bjoerke/DMM-counter-multimeter/README.md

# DMM-counter-multimeter
Impulszähler und Multimeter für das DMM-Board
