bjoerke/DMM-counter-multimeter/hardware/schematic.pdf

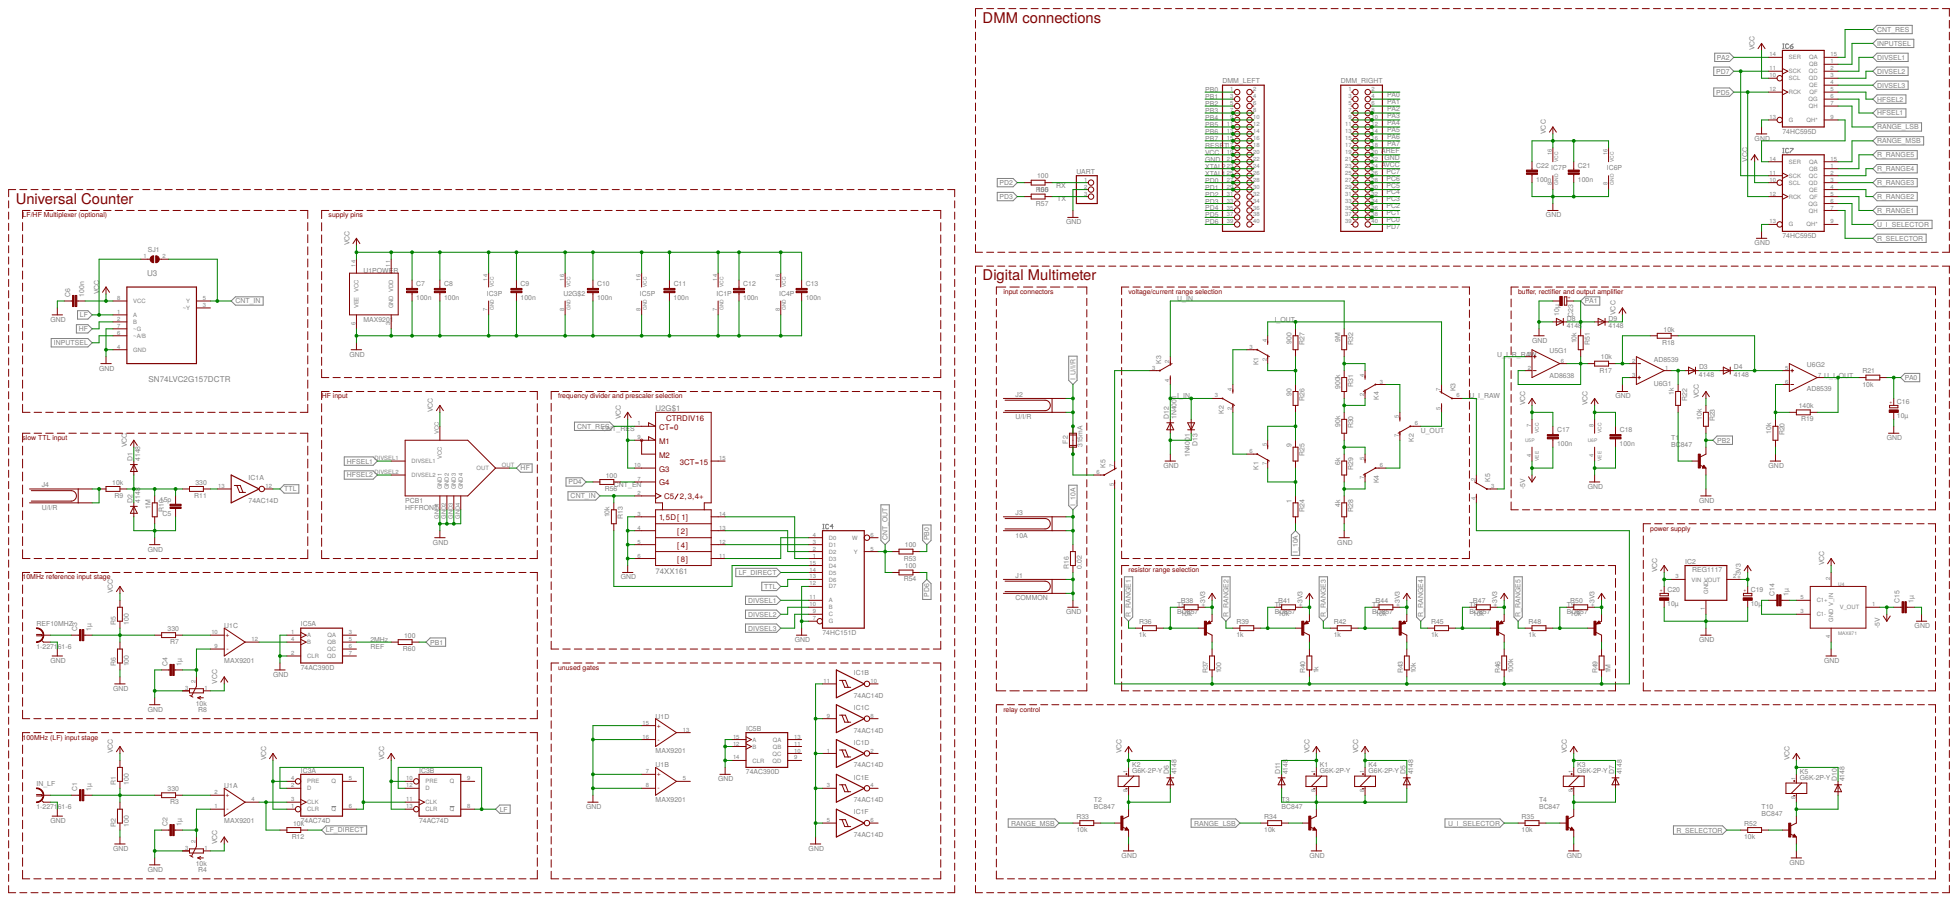
[picture p1: page 1]

HF input slow TTL input

frequency divider and prescaler selection
