bjoerke/DMM-counter-multimeter/hardware/counterMeterFixes.brd

## EAGLE design hardware/counterMeterFixes.brd (2016-05-24)

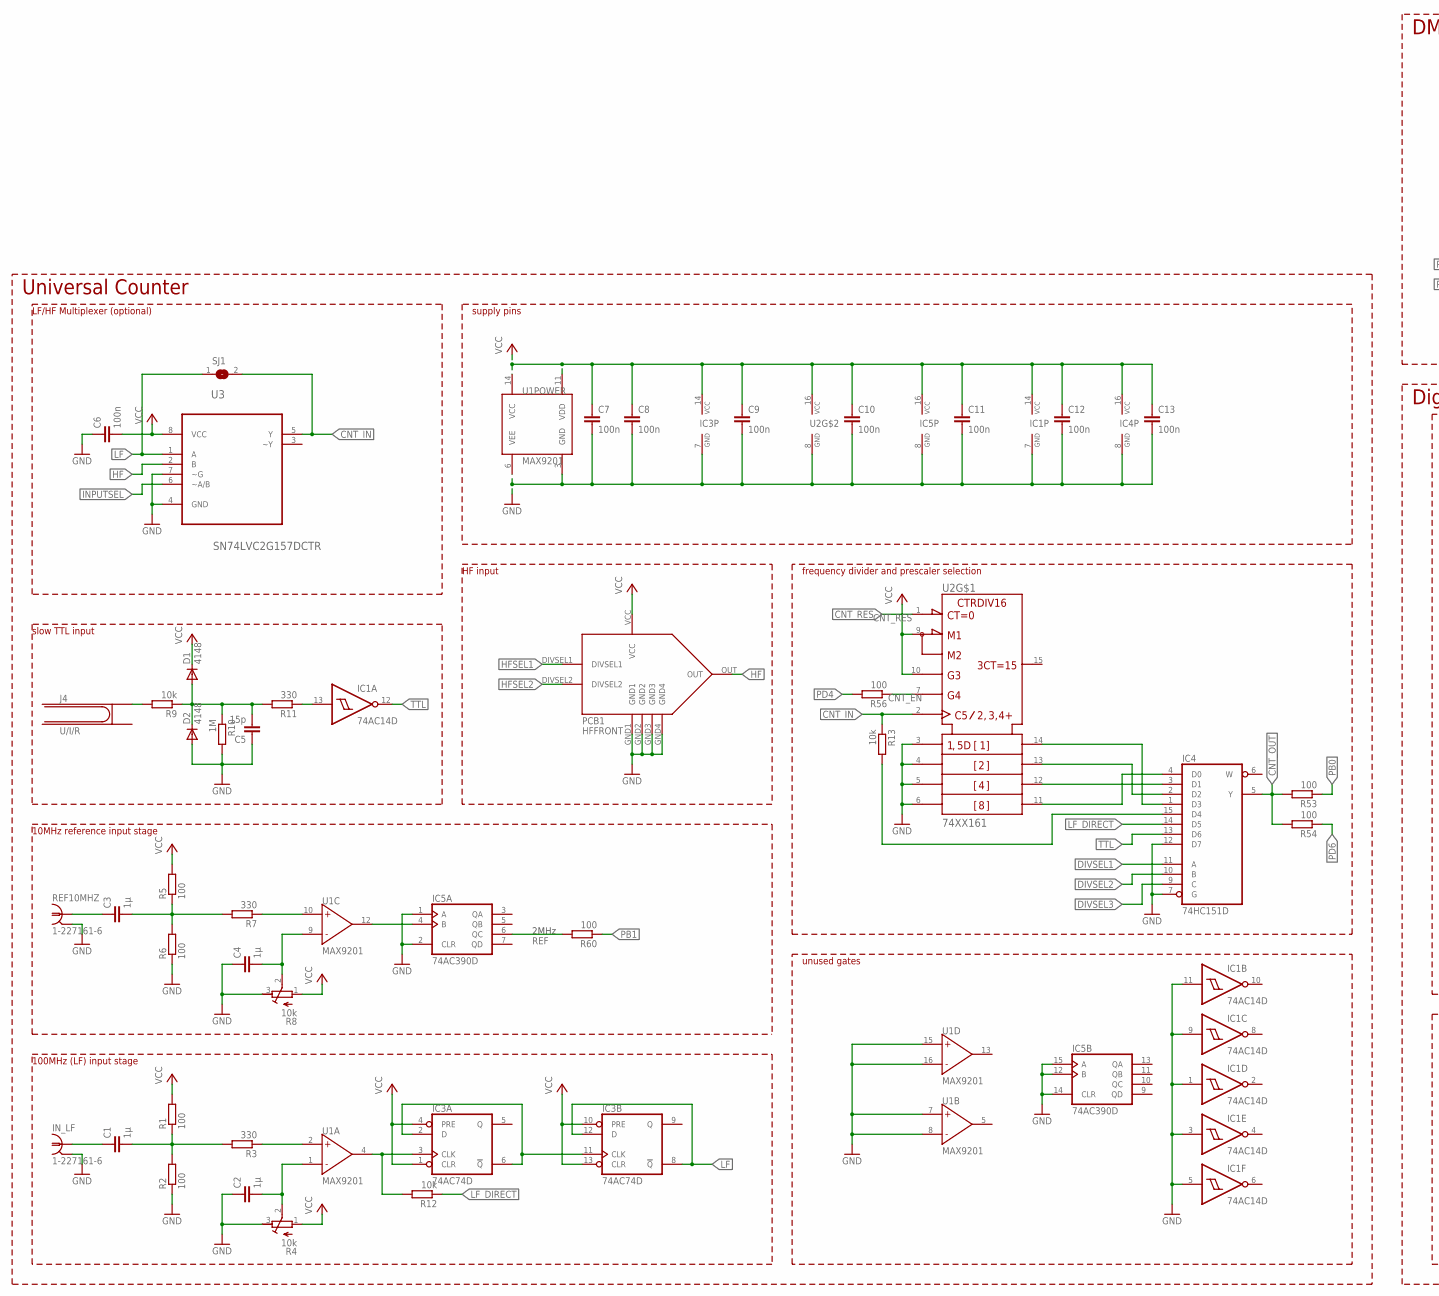
[picture p2: schematic counterMeterFixes.sch, part in row 1, column 1]

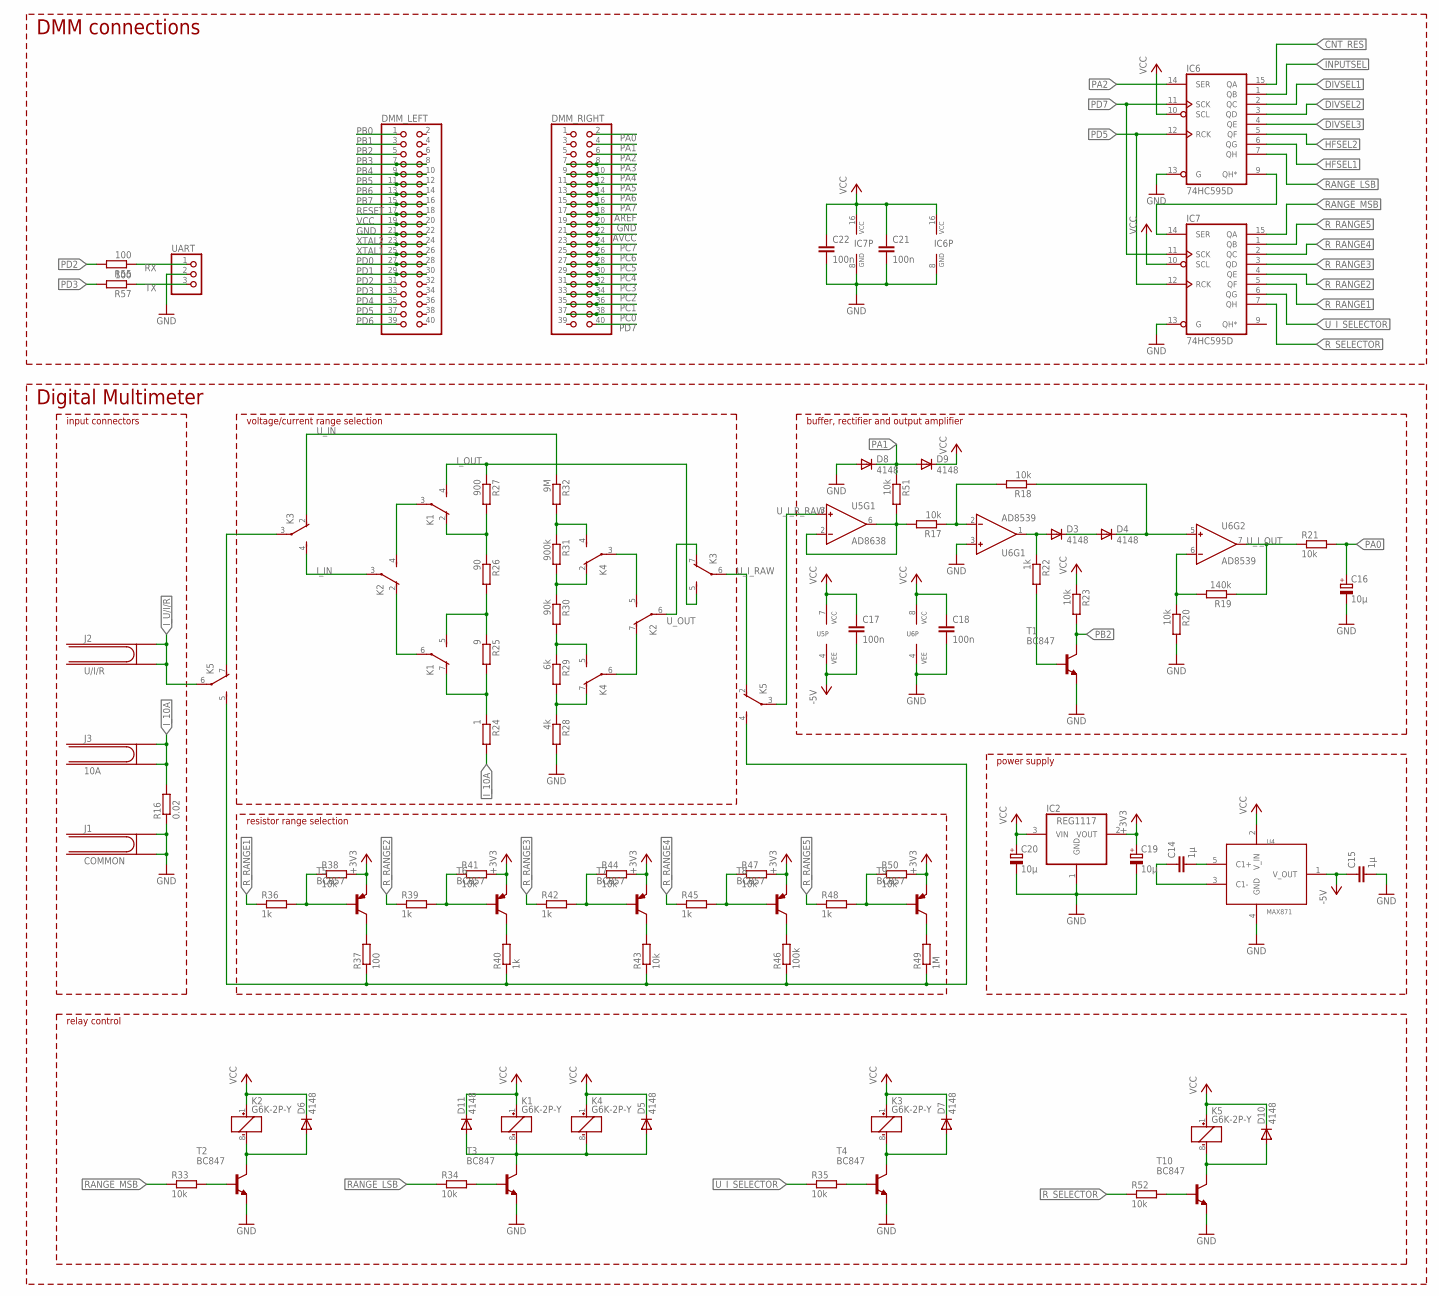
[picture p3: schematic counterMeterFixes.sch, part in row 1, column 2]

Parts:
C1, C2, C3, C4, C14, C15: 1µ; C0603
C5: 15p; C0603
C6, C7, C8, C9, C10, C11, C12, C13, C17, C18, C21, C22: 100n; C0603
C16, C19, C20: 10µ; E2-5
D1, D2, D3, D4, D5, D6, D7, D8, D9, D10, D11: 4148; SOD323-W
DMM_LEFT: PINHD-2X20; 2X20
DMM_RIGHT: PINHD-2X20; 2X20
IC1: 74AC14D; SO14
IC2: REG1117; SOT223
IC3: 74AC74D; SO14
IC4: 74HC151D; SO16
IC5: 74AC390D; SO16
IC6, IC7: 74HC595D; SO16
IN_LF: 1-227161-6; AMP_227161
J1: COMMON; 4MMJACK
J2, J4: U/I/R; 4MMJACK
J3: 10A; 4MMJACK
K1, K2, K3, K4, K5: G6K-2P-Y
PCB1: HFFRONT
R1, R2, R5, R6, R37, R53, R54, R55, R56, R57, R60: 100; R0603
R3, R7, R11: 330; R0603
R4, R8: 10k; RTRIM64W
R9, R12, R13, R17, R18, R20, R21, R23, R33, R34, R35, R38, R41, R43, R44, R47, R50, R51, R52: 10k; R0603
R10, R49: 1M; R0603
R16: 0.02; R2512
R19: 140k; R0603
R22, R36, R39, R40, R42, R45, R48: 1k; R0603
R24: 1; R0603
R25: 9; R0603
R26: 90; R0603
R27: 900; R0603
R28: 4k; R0603
R29: 6k; R0603
R30: 90k; R0603
R31: 900k; R0603
R32: 9M; R0603
R46: 100k; R0603
REF10MHZ: 1-227161-6; AMP_227161
SJ1: SJ
T1, T2, T3, T4, T10: BC847; SOT23
T5, T6, T7, T8, T9: BC857; SOT23-BEC
U1: MAX9201; SOIC16
U2: 74XX161; SOIC16
U3: SN74LVC2G157DCTR; SOP65P400X130-8N
U4: MAX871; SOT23-5
U5: AD8638; SOIC8
U6: AD8539; SOIC8
UART: PINHD-1X3; 1X03

Connections:
+3V3: C19.+, IC2.2 (VOUT), R38.2, R41.2, R44.2, R47.2, R50.2, T5.E, T6.E, T7.E, T8.E, T9.E
-5V: C15.1, C17.2, U4.1 (V_OUT), U5.4 (VEE)
AREF: DMM_RIGHT.17, DMM_RIGHT.18
AVCC: DMM_RIGHT.21, DMM_RIGHT.22
CNT_EN: R56.1, U2.7 (ENP)
CNT_IN: R13.1, SJ1.2, U2.2 (CLK), U3.5 (Y)
CNT_IN_: IC4.15 (D4), R13.2
CNT_OUT: IC4.5 (Y), R53.2, R54.2
CNT_RES: IC6.15 (QA), U2.1 (!CLR)
DIVSEL1: IC4.11 (A), IC6.2 (QC)
DIVSEL2: IC4.10 (B), IC6.3 (QD)
DIVSEL3: IC4.9 (C), IC6.4 (QE)
GND: C2.1, C4.1, C5.1, C6.1, C7.2, C8.2, C9.2, C10.2, C11.2, C12.2, C13.2, C15.2, C16.-, C18.2, C19.-, C20.-, C21.2, C22.2, D2.A, D8.A, DMM_LEFT.21, DMM_LEFT.22, DMM_RIGHT.19, DMM_RIGHT.20, IC1.1 (I), IC1.3 (I), IC1.5 (I), IC1.7 (GND), IC1.9 (I), IC1.11 (I), IC2.1 (GND), IC3.7 (GND), IC4.7 (G), IC4.8 (GND), IC4.12 (D7), IC5.1 (A), IC5.2 (CLR), IC5.8 (GND), IC5.12 (B), IC5.14 (CLR), IC5.15 (A), IC6.8 (GND), IC6.13 (G), IC7.8 (GND), IC7.13 (G), IN_LF.2, J1.1@1 (1), J1.1@2 (2), PCB1.GND1, PCB1.GND2, PCB1.GND3, PCB1.GND4, R2.1, R4.3 (A), R6.1, R8.3 (A), R10.2, R16.1, R20.2, R28.2, REF10MHZ.2, T1.2 (E), T2.2 (E), T3.2 (E), T4.2 (E), T10.2 (E), U1.3 (GND), U1.6 (VEE), U1.7 (IN+), U1.8 (IN-), U1.15 (IN+), U1.16 (IN-), U2.3 (A), U2.4 (B), U2.5 (C), U2.6 (D), U2.8 (GND), U3.4 (GND), U3.7 (~G), U4.4 (GND), U6.3 (IN+), U6.4 (VEE), UART.2
HF: PCB1.OUT, U3.2 (B)
HFSEL1: IC6.6 (QG), PCB1.DIVSEL1
HFSEL2: IC6.5 (QF), PCB1.DIVSEL2
INPUTSEL: IC6.1 (QB), U3.6 (~A/B)
I_10A: J3.1@1 (1), J3.1@2 (2), R16.2, R24.2
I_IN: K2.3, K3.4 (S)
I_OUT: K1.4 (S), K3.5 (S), R27.1
I_U/I/R: J2.1@1 (1), J2.1@2 (2), K5.6
LF: IC3.8 (!Q), IC3.12 (D), SJ1.1, U3.1 (A)
LF_DIRECT: IC4.14 (D5), R12.1
LF_SIG: IC3.3 (CLK), R12.2, U1.4 (OUT)
unnamed: C2.2, R4.2 (S), U1.1 (IN-)
unnamed: R3.1, U1.2 (IN+)
unnamed: C1.2, R1.1, R2.2, R3.2
unnamed: C1.1, IN_LF.1
unnamed: C4.2, R8.2 (S), U1.9 (IN-)
unnamed: R7.1, U1.10 (IN+)
unnamed: C3.2, R5.1, R6.2, R7.2
unnamed: C3.1, REF10MHZ.1
unnamed: J4.1@1 (1), R9.2
unnamed: C5.2, D1.A, D2.C, R9.1, R10.1, R11.2
unnamed: IC1.13 (I), R11.1
unnamed: K4.7 (O), R28.1, R29.2
unnamed: IC5.4 (B), U1.12 (OUT)
unnamed: IC4.1 (D3), U2.14 (QA)
unnamed: K1.3, K2.4 (S)
unnamed: IC4.2 (D2), U2.13 (QB)
unnamed: IC4.3 (D1), U2.12 (QC)
unnamed: IC4.4 (D0), U2.11 (QD)
unnamed: C14.2, U4.5 (C1+)
unnamed: C14.1, U4.3 (C1-)
unnamed: D3.A, R22.1, U6.1 (OUT)
unnamed: D4.C, R18.1, U6.5 (IN+)
unnamed: R19.2, R20.1, U6.6 (IN-)
unnamed: IC6.9 (QH*), IC7.14 (SER)
unnamed: R17.1, R18.2, U6.2 (IN-)
unnamed: R17.2, R51.2, U5.2 (IN-), U5.6 (OUT)
unnamed: D3.C, D4.A
unnamed: R22.2, T1.1 (B)
unnamed: K1.7 (O), R24.1, R25.2
unnamed: K1.5 (S), R25.1, R26.2
unnamed: K1.2 (O), R26.1, R27.2
unnamed: K1.6, K2.2 (O)
unnamed: K4.5 (S), R29.1, R30.2
unnamed: K4.2 (O), R30.1, R31.2
unnamed: K4.4 (S), R31.1, R32.2
unnamed: K2.5 (S), K4.3
unnamed: K2.7 (O), K4.6
unnamed: D6.A, K2.8 (-), T2.3 (C)
unnamed: R33.2, T2.1 (B)
unnamed: D5.A, D11.A, K1.8 (-), K4.8 (-), T3.3 (C)
unnamed: R34.2, T3.1 (B)
unnamed: R35.2, T4.1 (B)
unnamed: D7.A, K3.8 (-), T4.3 (C)
unnamed: R36.2, R38.1, T5.B
unnamed: R37.2, T5.C
unnamed: K3.3, K5.7 (O)
unnamed: IC3.2 (D), IC3.6 (!Q), IC3.11 (CLK)
unnamed: R39.2, R41.1, T6.B
unnamed: R40.2, T6.C
unnamed: R42.2, R44.1, T7.B
unnamed: R43.2, T7.C
unnamed: R45.2, R47.1, T8.B
unnamed: R46.2, T8.C
unnamed: R48.2, R50.1, T9.B
unnamed: R49.2, T9.C
unnamed: K5.4 (S), K5.5 (S), R37.1, R40.1, R43.1, R46.1, R49.1
unnamed: R52.2, T10.1 (B)
unnamed: D10.A, K5.8 (-), T10.3 (C)
PA0: C16.+, DMM_RIGHT.2, R21.2
PA1: D8.C, D9.A, DMM_RIGHT.4, R51.1
PA2: DMM_RIGHT.6, IC6.14 (SER)
PA3: DMM_RIGHT.7, DMM_RIGHT.8
PA4: DMM_RIGHT.9, DMM_RIGHT.10
PA5: DMM_RIGHT.11, DMM_RIGHT.12
PA6: DMM_RIGHT.13, DMM_RIGHT.14
PA7: DMM_RIGHT.15, DMM_RIGHT.16
PB0: DMM_LEFT.1, R53.1
PB1: DMM_LEFT.3, R60.1
PB2: DMM_LEFT.5, R23.2, T1.3 (C)
PB3: DMM_LEFT.7, DMM_LEFT.8
PB4: DMM_LEFT.9, DMM_LEFT.10
PB5: DMM_LEFT.11, DMM_LEFT.12
PB6: DMM_LEFT.13, DMM_LEFT.14
PB7: DMM_LEFT.15, DMM_LEFT.16
PC0: DMM_RIGHT.37, DMM_RIGHT.38
PC1: DMM_RIGHT.35, DMM_RIGHT.36
PC2: DMM_RIGHT.33, DMM_RIGHT.34
PC3: DMM_RIGHT.31, DMM_RIGHT.32
PC4: DMM_RIGHT.29, DMM_RIGHT.30
PC5: DMM_RIGHT.27, DMM_RIGHT.28
PC6: DMM_RIGHT.25, DMM_RIGHT.26
PC7: DMM_RIGHT.23, DMM_RIGHT.24
PD0: DMM_LEFT.27, DMM_LEFT.28
PD1: DMM_LEFT.29, DMM_LEFT.30
PD2: DMM_LEFT.31, R55.2
PD3: DMM_LEFT.33, R57.2
PD4: DMM_LEFT.35, R56.2
PD5: DMM_LEFT.37, IC6.12 (RCK), IC7.12 (RCK)
PD6: DMM_LEFT.39, R54.1
PD7: DMM_RIGHT.40, IC6.11 (SCK), IC7.11 (SCK)
RANGE_LSB: IC6.7 (QH), R34.1
RANGE_MSB: IC7.15 (QA), R33.1
REF: IC5.6 (QC), R60.2
RESET: DMM_LEFT.17, DMM_LEFT.18
RX: R55.1, UART.1
R_RANGE1: IC7.5 (QF), R36.1
R_RANGE2: IC7.4 (QE), R39.1
R_RANGE3: IC7.3 (QD), R42.1
R_RANGE4: IC7.2 (QC), R45.1
R_RANGE5: IC7.1 (QB), R48.1
R_SELECTOR: IC7.7 (QH), R52.1
TTL: IC1.12 (O), IC4.13 (D6)
TX: R57.1, UART.3
U_IN: K3.2 (O), R32.1
U_I_OUT: R19.1, R21.1, U6.7 (OUT)
U_I_RAW: K3.6, K5.2 (O)
U_I_R_RAW: K5.3, U5.3 (IN+)
U_I_SELECTOR: IC7.6 (QG), R35.1
U_OUT: K2.6, K3.7 (O)
VCC: C6.2, C7.1, C8.1, C9.1, C10.1, C11.1, C12.1, C13.1, C17.1, C18.1, C20.+, C21.1, C22.1, D1.C, D5.C, D6.C, D7.C, D9.C, D10.C, D11.C, DMM_LEFT.19, DMM_LEFT.20, IC1.14 (VCC), IC2.3 (VIN), IC3.1 (CLR), IC3.4 (PRE), IC3.10 (PRE), IC3.13 (CLR), IC3.14 (VCC), IC4.16 (VCC), IC5.16 (VCC), IC6.10 (SCL), IC6.16 (VCC), IC7.10 (SCL), IC7.16 (VCC), K1.1 (+), K2.1 (+), K3.1 (+), K4.1 (+), K5.1 (+), PCB1.VCC, R1.2, R4.1 (E), R5.2, R8.1 (E), R23.1, U1.11 (VDD), U1.14 (VCC), U2.9 (!LOAD), U2.10 (ENT), U2.16 (VCC), U3.8 (VCC), U4.2 (V_IN), U5.7 (VCC), U6.8 (VCC)
XTAL1: DMM_LEFT.25, DMM_LEFT.26
XTAL2: DMM_LEFT.23, DMM_LEFT.24

Notes on the sheet:
10MHz reference input stage
HF input
slow TTL input
100MHz (LF) input stage
LF/HF Multiplexer (optional)
2MHz
supply pins
frequency divider and prescaler selection
unused gates
Universal Counter
relay control
resistor range selection
voltage/current range selection
buffer, rectifier and output amplifier
input connectors
power supply
Digital Multimeter
DMM connections

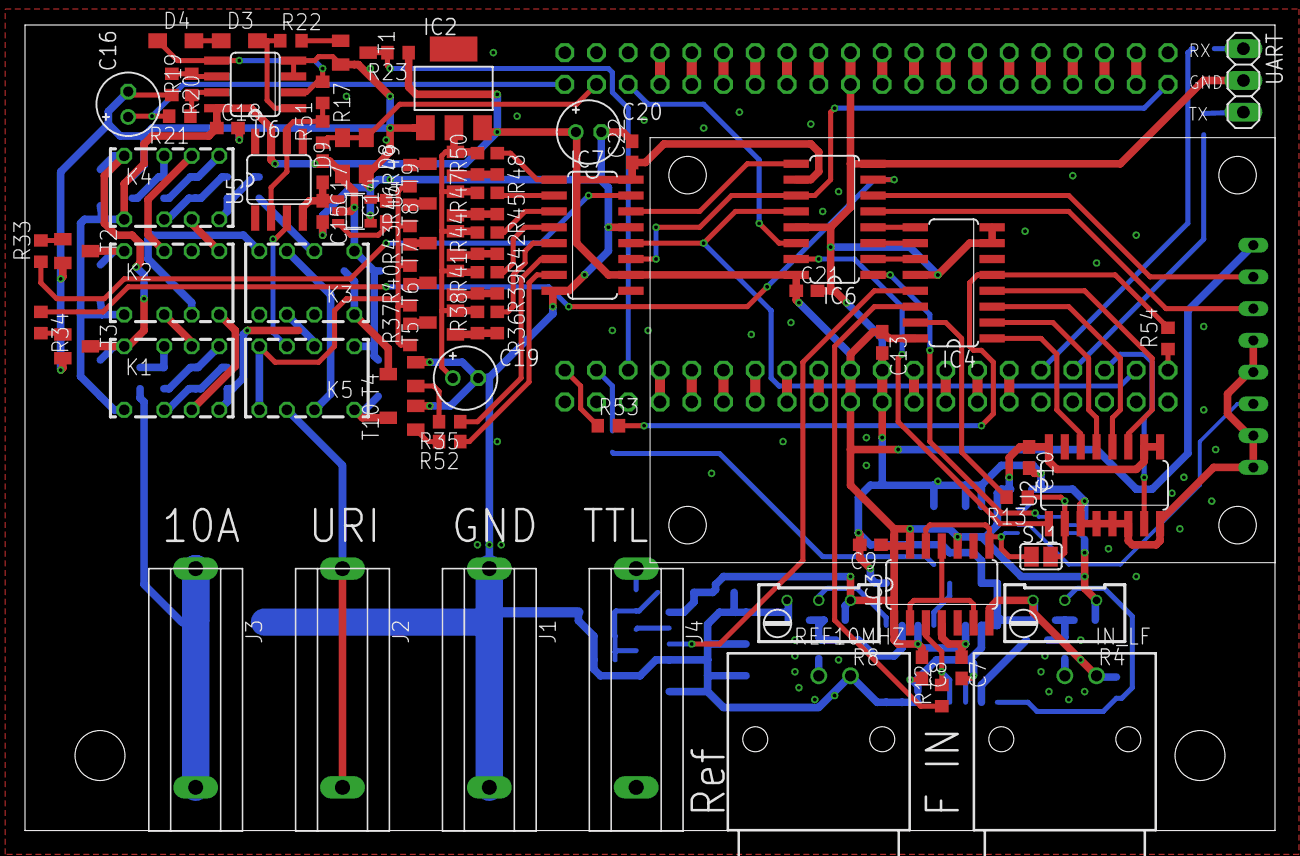
[picture p4: board counterMeterFixes.brd from above]

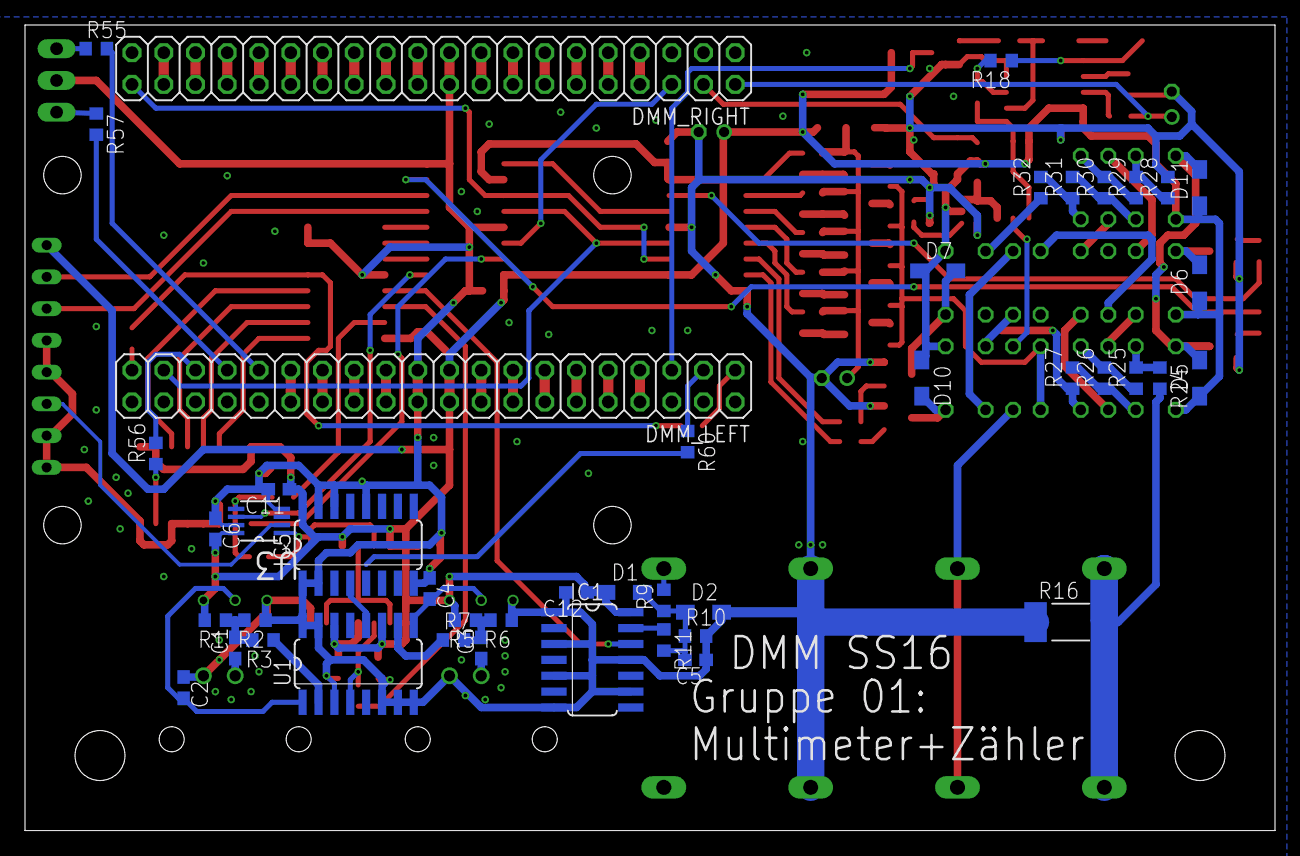
[picture p5: board counterMeterFixes.brd from below]

Board: 2 copper layers, 100.0 x 64.4 mm, 128 parts (45 on the bottom side), 136 nets.
