bjoerke/DMM-counter-multimeter/hardware/HF_front.brd

## EAGLE design hardware/HF_front.brd (2016-05-02)

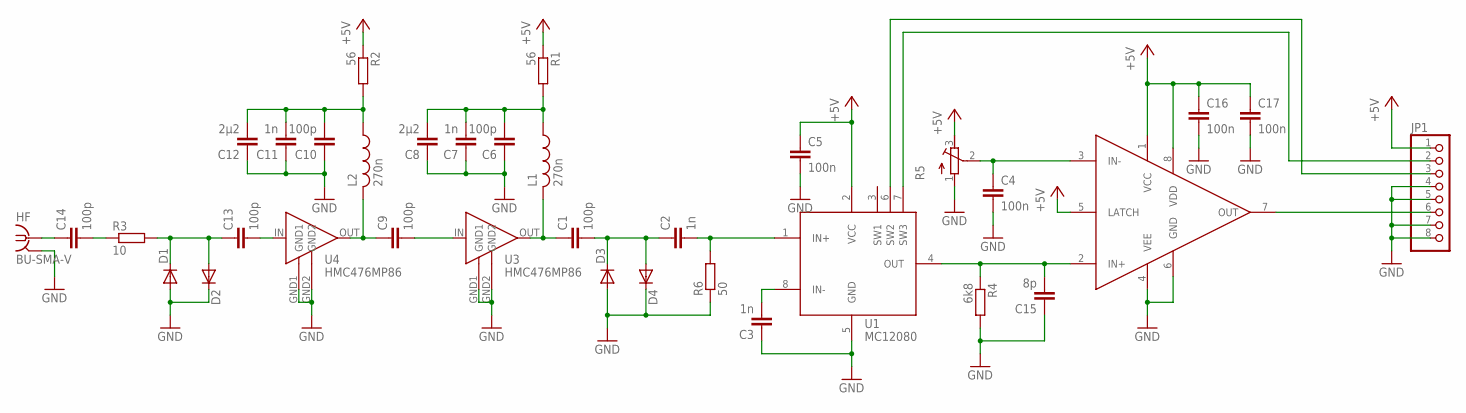
[picture p6: schematic HF_front.sch]

Parts:
C1, C6, C9, C10, C13, C14: 100p; C0603
C2, C3, C7, C11: 1n; C0603
C4, C5, C16, C17: 100n; C0603
C8, C12: 2µ2; C0603
C15: 8p; C0603
D1, D2, D3, D4: DIODE-SOD323-W; SOD323-W
HF: BU-SMA-V
JP1: PINHD-1X8; 1X08
L1, L2: 270n; R0603
R1, R2: 56; R0603
R3: 10; R0603
R4: 6k8; R0603
R5: R-TRIMM64W; RTRIM64W
R6: 50; R0603
U1: MC12080; SOIC8
U2: MAX9203; SOIC8
U3, U4: HMC476MP86; MICRO-X

Connections:
+5V: C5.1, C16.1, C17.1, JP1.1, R1.1, R2.1, R5.3 (A), U1.2 (VCC), U2.1 (VCC), U2.5 (LATCH), U2.8 (VDD)
GND: C3.1, C4.2, C5.2, C6.1, C7.1, C8.1, C10.1, C11.1, C12.1, C15.1, C16.2, C17.2, D1.A, D2.C, D3.A, D4.C, HF.2, HF.3 (2), HF.4 (2), HF.5 (2), JP1.4, JP1.5, JP1.7, JP1.8, R4.2, R5.1 (E), R6.1, U1.5 (GND), U2.4 (VEE), U2.6 (GND), U3.GND1, U3.GND2, U4.GND1, U4.GND2
unnamed: C6.2, C7.2, C8.2, L1.1, R1.2
unnamed: C1.1, L1.2, U3.OUT
unnamed: C10.2, C11.2, C12.2, L2.1, R2.2
unnamed: C9.1, L2.2, U4.OUT
unnamed: C9.2, U3.IN
unnamed: C2.2, R6.2, U1.1 (IN+)
unnamed: C3.2, U1.8 (IN-)
unnamed: C15.2, R4.1, U1.4 (OUT), U2.2 (IN+)
unnamed: C4.1, R5.2 (S), U2.3 (IN-)
unnamed: C14.1, HF.1
unnamed: C14.2, R3.1
unnamed: C13.1, D1.C, D2.A, R3.2
unnamed: C13.2, U4.IN
unnamed: C1.2, C2.1, D3.C, D4.A
unnamed: JP1.6, U2.7 (OUT)
unnamed: JP1.2, U1.7 (SW3)
unnamed: JP1.3, U1.6 (SW2)

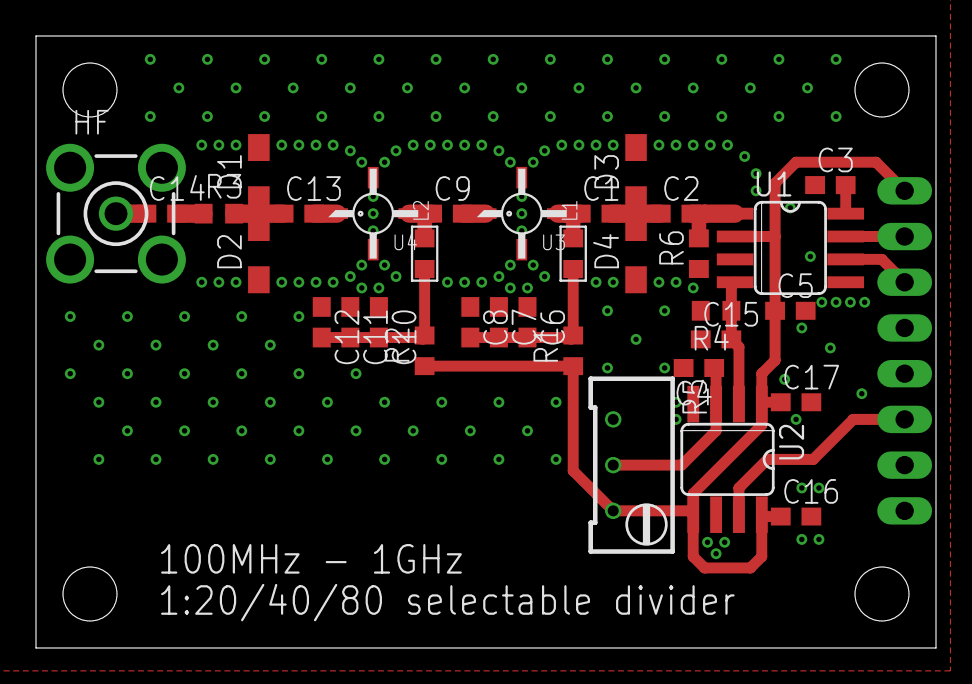
[picture p7: board HF_front.brd from above]

Board: 2 copper layers, 50.0 x 34.0 mm, 35 parts (1 on the bottom side), 19 nets.
