bjoerke/DMM-counter-multimeter/(commit log)

2016-04-28 first draw of the schematic
    [counterMeter.sch]
2016-04-28 optional HF frontend board
    [HF_front.brd, HF_front.sch]
2016-05-01 some pin changes in schematic + first draw of the PCB layout
    [counterMeter.brd, counterMeter.sch]
2016-05-01 schematic as pdf
2016-05-01 some low level drivers for the counter part
2016-05-02 some input protection + buffer output filter
    [counterMeter.brd, counterMeter.sch]
2016-05-02 more minor pcb changes
    [HF_front.brd, HF_front.sch, counterMeter.brd, counterMeter.sch]
2016-05-02 partlist counterMeter
    [bom.xls]
2016-05-02 updated pdf schematic
2016-05-02 Updated partlist
    Updated and changed the partlist to the requested format.
    [partlist.xlsx]
2016-05-02 added simulation feature (debugging just with the DMM board possible)
2016-05-03 tiny layout correction
    [counterMeter.brd]
2016-05-03 Gerber files for PCB production
2016-05-09 corrected a link and erased column
    [partlist.xlsx]
2016-05-16 Again an update of the partlist
    [partlist.xlsx]
2016-05-24 Bugfix: forgot shift of shift register content. Plus stretching the clock pulses slightly
    [shiftreg.c]
2016-05-24 relay contacts 5 and 7 on K3 swapped
    [counterMeterFixes.brd, counterMeterFixes.sch]
2016-05-24 corrected frequency division of reference signal IC5A Pin 6 instead of 5
    [counterMeterFixes.brd, counterMeterFixes.sch]
2016-06-01 First UART test
2016-06-01 Added listener to uart driver
2016-06-01 UART Protocol stub
2016-06-02 Moved schematics to seperate folder
    [HF_front.brd, HF_front.sch, bom.xls, counterMeter.brd, counterMeter.sch, counterMeterFixes.brd, counterMeterFixes.sch, partlist.xlsx]
2016-06-08 Updated the main.c
    Hopefully merged both while-loops correctly. Additionally added a new function.
    [main.c]
2016-06-11 wait for fifo ready in UART_PutChar + UART_PutLongInteger added
2016-06-11 maximum sample time limited + maximum capture frequency
2016-06-14 Prepared the multimeter for ADC. Init in main.
2016-06-15 ADC fixes
2016-06-16 bug fixes (interrupt flag + overflows)
    [counterHAL.c]
2016-06-16 more bugfixes (reduced maximum input frequency, overflow) + debug msgs
    [counter.c, counter.h]
2016-06-16 allow timer callback registration (10ms), will be used for debouncing
2016-06-24 Application for testing the uart protocol
2016-07-01 Autorange borders moved -> got rid of oscillation between ranges
    [multimeter.c]
2016-07-01 reduced some redundancies in the multimeter code + new GUI things
    Multimeter:
    - Redundancies reduced in voltage, current and resistance measurement
    - Continuity measurement fixed on 2kOhm range
    - Display color changes in continuity mode
    GUI:
    - display selected range in auto mode on top of screen
    - 'OutOfRange' instead of measurement results if measurement is close to
    limit
    [gui.c, gui.h, multimeter.c, multimeter.h]
2016-07-01 bugfix: ranges on I-mode didn't change
    [multimeter.c]
2016-07-02 display correct units + improvement on resistance auto ranging
    [gui.c, gui.h, multimeter.c, multimeter.h]
2016-07-03 Finished uart protocol
2016-07-05 bugfix counter: indirect method only worked with prescaler 1 and 4
    [counterHAL.c]
2016-07-05 included calculation of the adc-mean
    see function adc_get()
2016-07-06 Changed uart protocol
2016-07-07 optional timeout on uartProtocol_WaitRequest
2016-07-07 Basic uart protocol integration
2016-07-07 bugfix: used reference instead of value
    [counter.c]
2016-07-07 Uart-protocol integrated (not fully tested yet)
2016-07-07 Minor bug fixes for uart-tester
    [protocol.c, serialio_unix.c]
2016-07-07 increased maximum pin frequency -> faster results
